ELEliseev/fb6-ebb/doc/4.jpeg

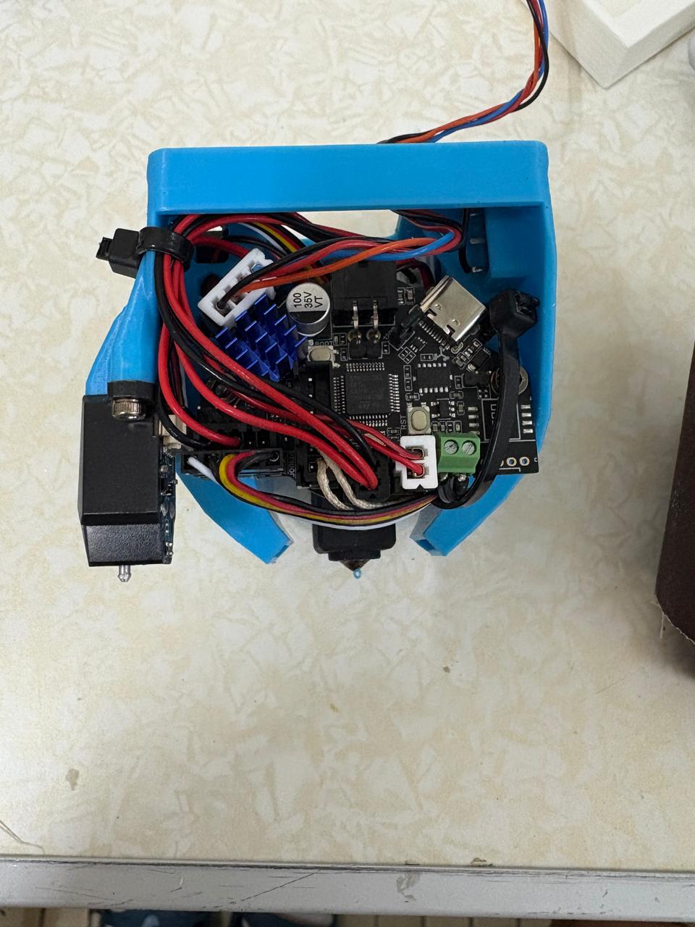
doc/4.jpeg
