ELEliseev/fb6-ebb/doc/10.jpeg

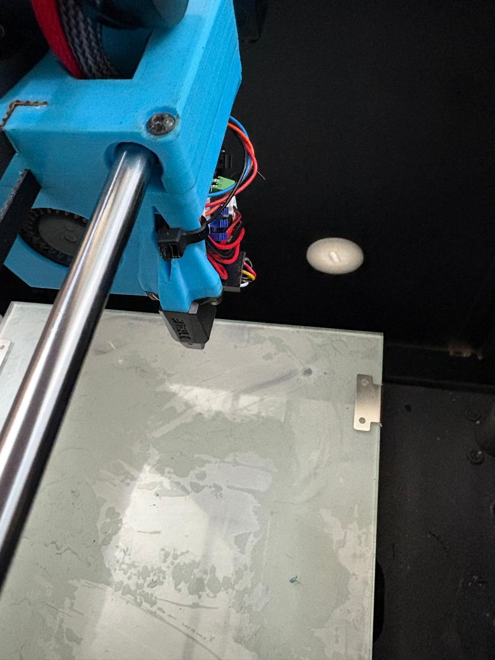
doc/10.jpeg
