ELEliseev/fb6-ebb/doc/Голова для 3д принтера flying bear ghost 6 под плату  ebb 36 can от btt.docx

## Голова для 3д принтера flying bear ghost 6 под плату ebb 36 can от btt.

### Данная система работает на прошивке klipper (у автора хост klipper на orange pi 3 lts)

> Печать

* Пластик ABS

* Слой 0.2мм

* Поддержки органические принудительно как на фото (каретка поддержки от стола)

* Периметры ,крышка, дно 5шт

* Заполнение 25% соты

> Плюсы

1. Избавляемся от лишних проводов, в том числе провод концевика X, который принтер вынужден таскать при печати.

2. Получаем акселерометр который встроен в плату, соответственно имеем автоматическую настройку input shaper.

3. Имеем нагреватель 60 ватт от volcano более надежный и мощный, также длинные каленые сопла.

4. Датчик microprobe biqu v2 легкий и при этом дает хорошие результаты в построении карты стола.

5. Голова получилась значительно легче штатной ,что позволяет печатать на высоких скоростях.

6. Все вентиляторы подходят от родной головы.

7. Совместимость с проектом zohan

>Минусы

1. Цена компонентов

2. Провода обжимать придется самостоятельно

> Компоненты

1. Хотенд volcano https://www.ozon.ru/product/rashodnik-dlya-pechati-chernyy-black-1992553845/

2. Микровыключатель https://www.ozon.ru/product/2sht-mikrovyklyuchatel-omron-d2fc-f-7n-komplektuyushchie-dlya-klaviatur-i-myshey-2011207511/ (опционально)

3. Плата ebb 36 btt https://www.ozon.ru/product/bigtreetech-ebb36-can-instrumentalnaya-plata-podderzhki-canbus-pt100-s-max31865-dlya-u2c-ender3-1994421029/

4. Плата u2c btt https://www.ozon.ru/product/plata-adaptera-bigtreetech-u2c-v2-1-podderzhivaet-podklyuchenie-shiny-can-s-3-can-vyhodnoy-interfeys-2018211076/ (опционально в зависимости от наличия CAN интерфейса на хосте klipper)

5. Вплавляемые втулки нужно 10 шт , 8 - м3, 2 - м2.5 для крепления microprobe.

6. Microprobe biqu v2 https://www.ozon.ru/product/biqu-microprobe-v2-datchik-avtomaticheskogo-vyravnivaniya-sensornyy-3d-datchik-dlya-ender-1919546110/ (опционально)

7. Экструдер orbiter v2.5 https://www.ozon.ru/product/ekstruder-orbiter-v2-5-s-pryamym-privo-2394542590/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 (опционально)

8. Разветвитель провода кулеров обдува, в плате ebb 36, к сожалению, только 2 выхода для обдува, а в нашей схеме 2 кулера обдува и 1 кулер охлаждения хотенда, поэтому необходим разветвитель, они бывают в продаже, также можно изготовить самому

>Прошивка

Обновляем Klipper.

Инструкция по установке klipper Tombraider2006/klipperFB6: flyingbear ghost 6 klipper/ helpfull manuals for user. config, mods, hacks (https://github.com/Tombraider2006/klipperFB6?ysclid=mf85sic02a98146775)

Прошиваем платы свежей прошивкой есть инструкции на сайте KB3D Wiki.

U2C BTT U2C v2.1 CANBus Adapter Board | KB3D Wiki (https://wiki.kb-3d.com/en/home/btt/voron/u2c_v2)

EBB 36 BTT EBB36 CAN Toolhead Board | KB3D Wiki (https://wiki.kb-3d.com/en/home/btt/voron/BTT_EBB36)

Прошиваем в режиме с бутлоадером что бы потом не парится с обновлениями

Плата ebb 36 может работать по двум интерфейса CAN и USB (автор использует CAN) соответственно существует 2 прошивки под CAN и USB.

> Сборка

Предусмотрите крепление плат (у автора платы вынесены на заднюю стенку в корпусах на магнитах, может быть не лучшее решение).

Предусмотрите прокладку кабелей, неплохое решение убрать кабели в оплетку «змеиная кожа».

Провода лучше использовать aws мягкие . Для кабеля головы сечение 0,3 мм на CAN шину и 0,5 мм на питание, провода CAN шины скручиваем в витую пару (автор использовал шуруповерт).

Перед сборкой прошиваем платы.

На конечных платах CAN шины (в схеме автора их всего 2 ebb36 и u2c ) включаем jumper 120 Ом для терминирования шины.

Блок-схема включения компонентов есть в прикрепленных файлах.

Голова собирается просто, можно посмотреть на фото, аккуратно раскладывайте и подбирайте длину проводов, внутри есть небольшой фиксатор для проводов.

Вплавляются втулки 2шт на orbiter, 2шт на microprobe v2, 2шт для платы ebb 36, 4шт для соединения с кареткой.

Провода подсоединять согласно схемам от завода плат.

>Настройка

Конфиг klipper пример от автора:
