ELEliseev/fb6-ebb/doc/1.jpeg

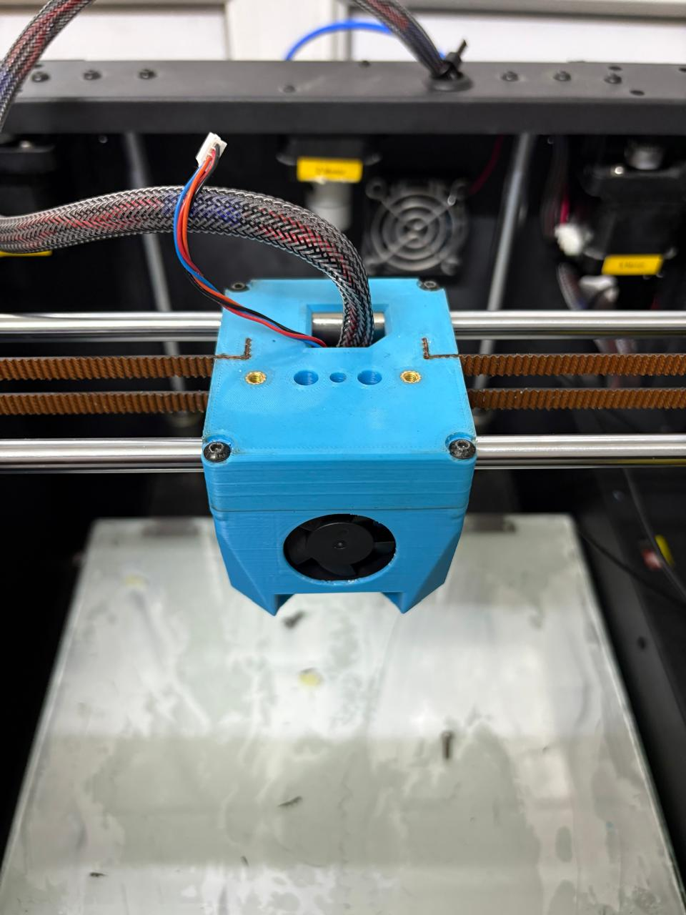
doc/1.jpeg
