ELEliseev/fb6-ebb/doc/2.jpeg

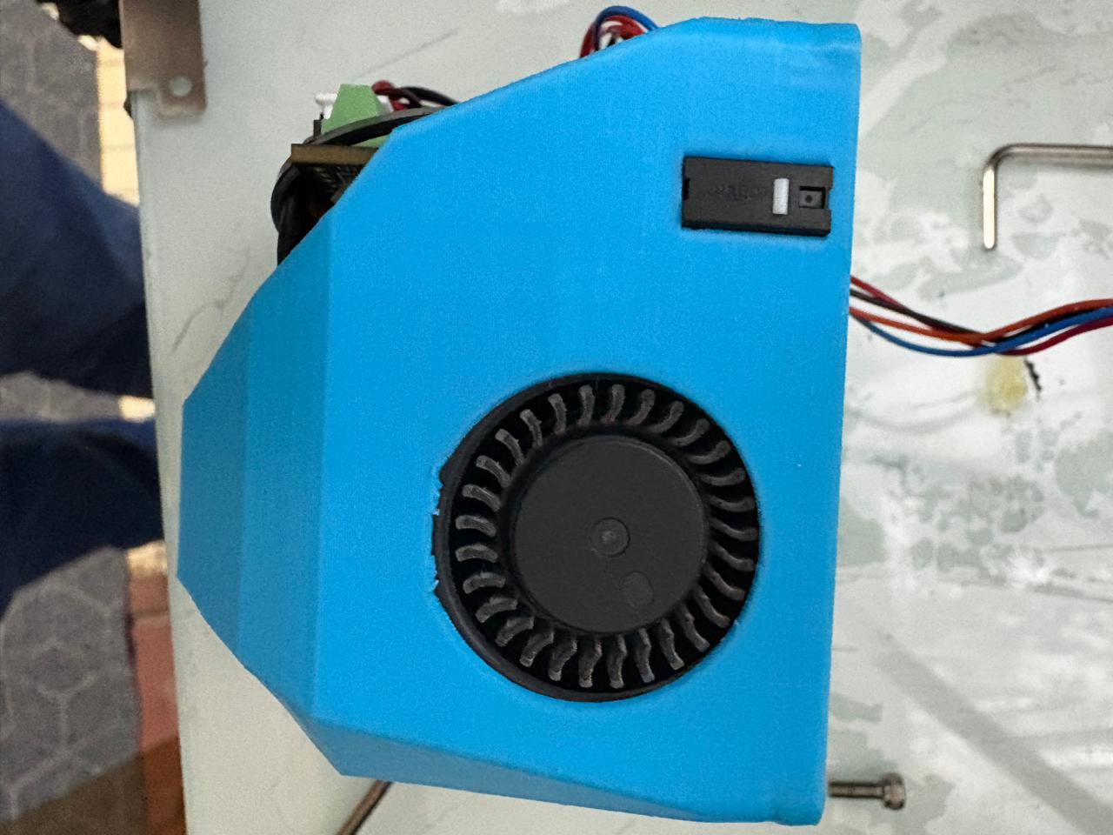
doc/2.jpeg
