ELEliseev/fb6-ebb/doc/3.jpeg

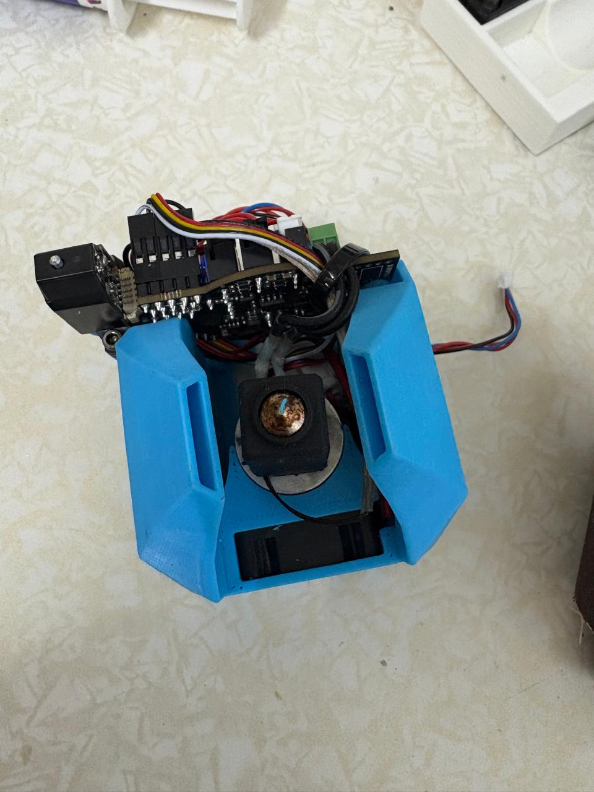
doc/3.jpeg
