ELEliseev/fb6-ebb/doc/5.jpeg

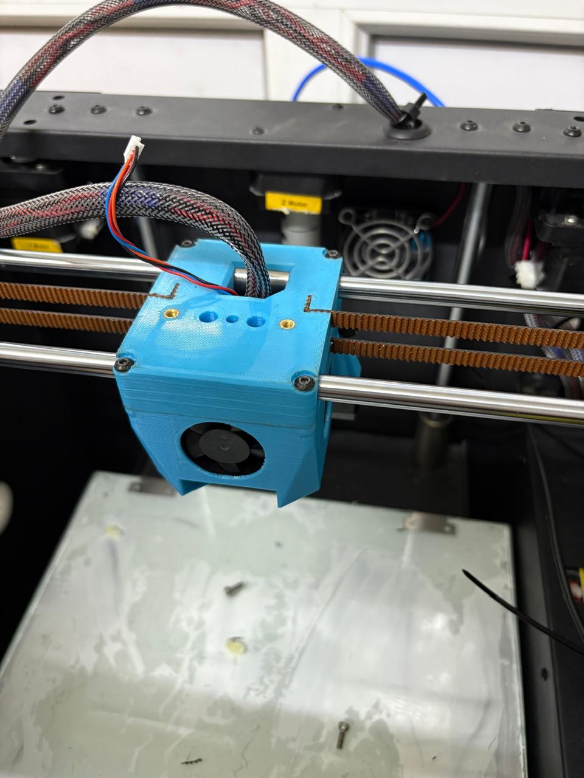
doc/5.jpeg
