ELEliseev/fb6-ebb/doc/6.jpeg

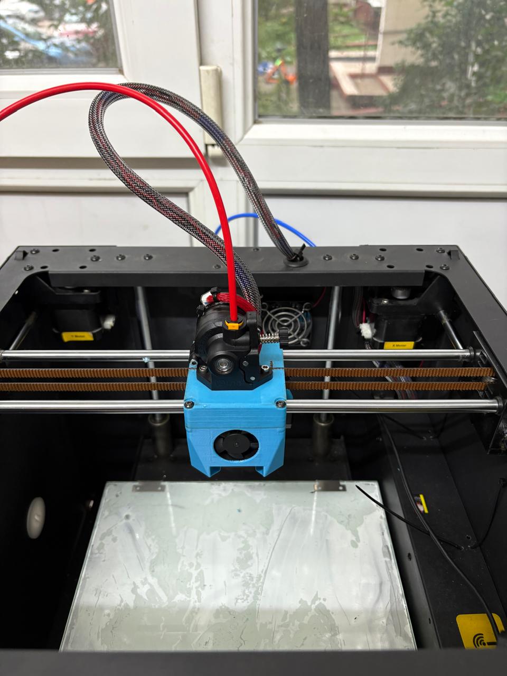
doc/6.jpeg
