ELEliseev/fb6-ebb/doc/7.jpeg

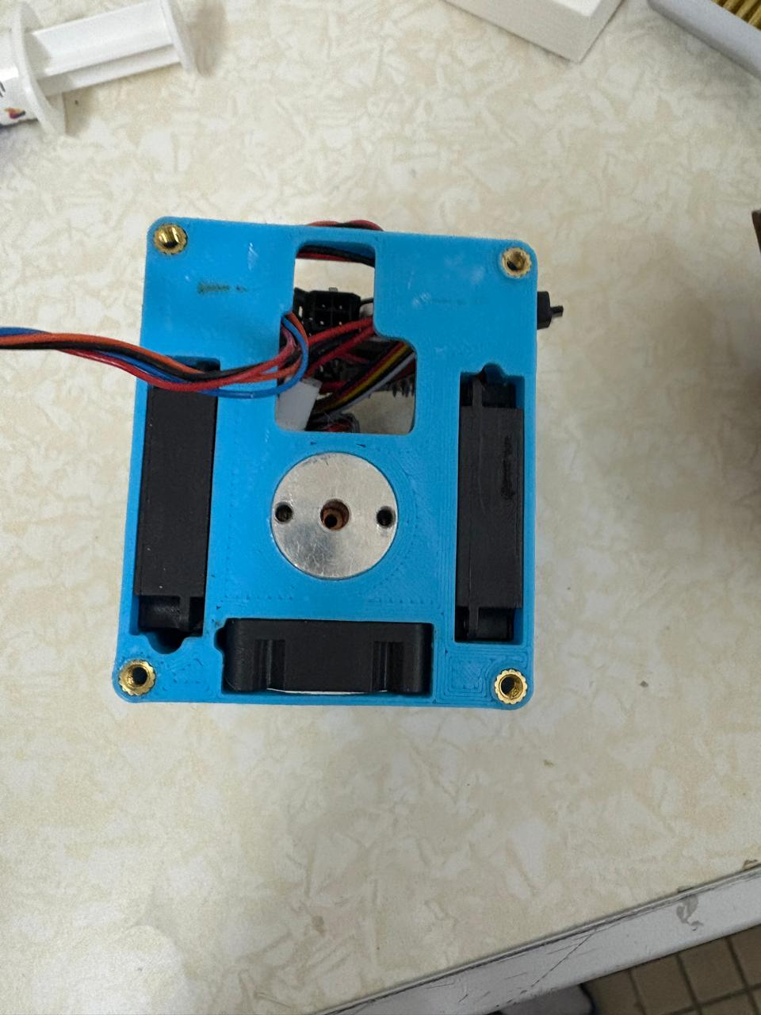
doc/7.jpeg
