ELEliseev/fb6-ebb/doc/8.jpeg

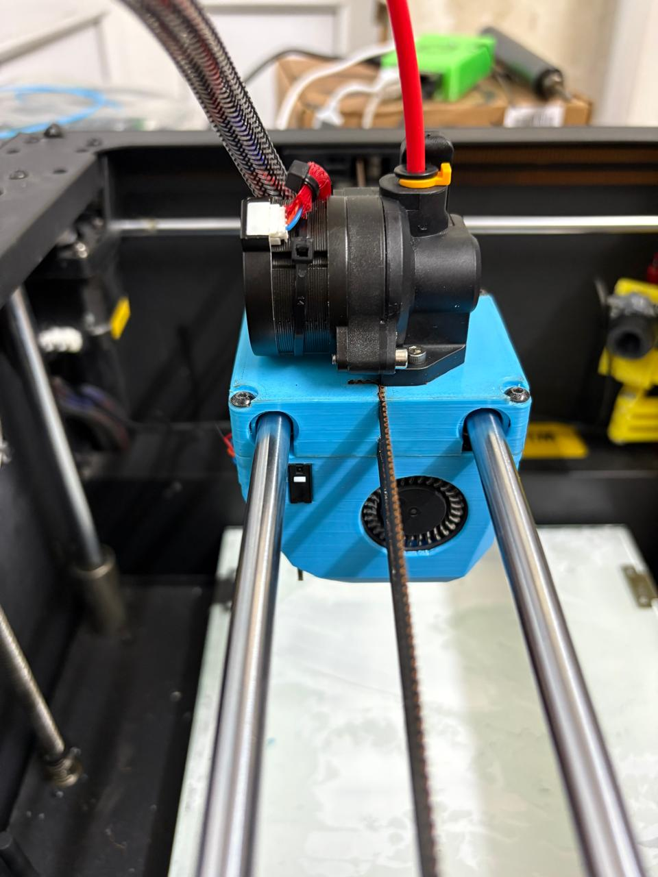
doc/8.jpeg
