ELEliseev/fb6-ebb/doc/9.jpeg

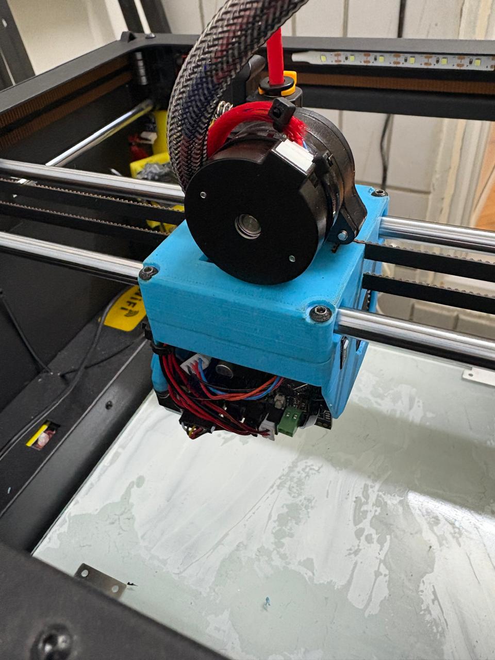
doc/9.jpeg
