ELEliseev/fb6-ebb/doc/11.jpeg

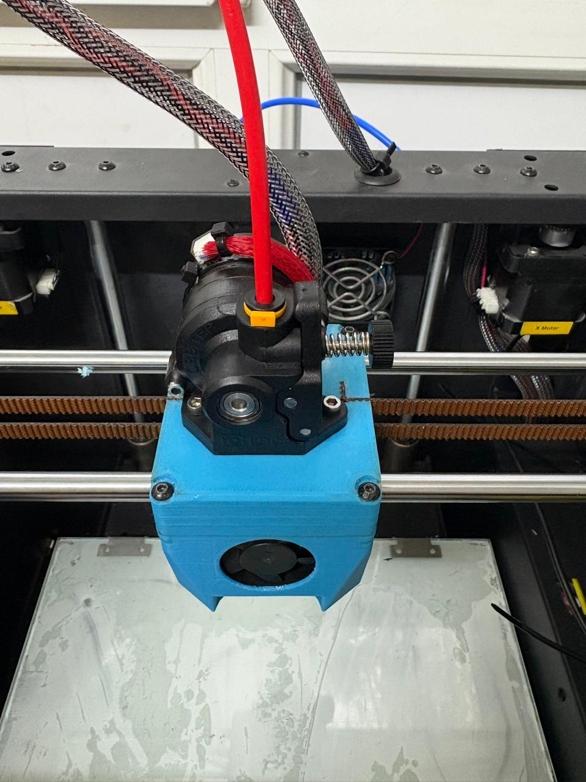
doc/11.jpeg
