ELEliseev/fb6-ebb/doc/12.jpeg

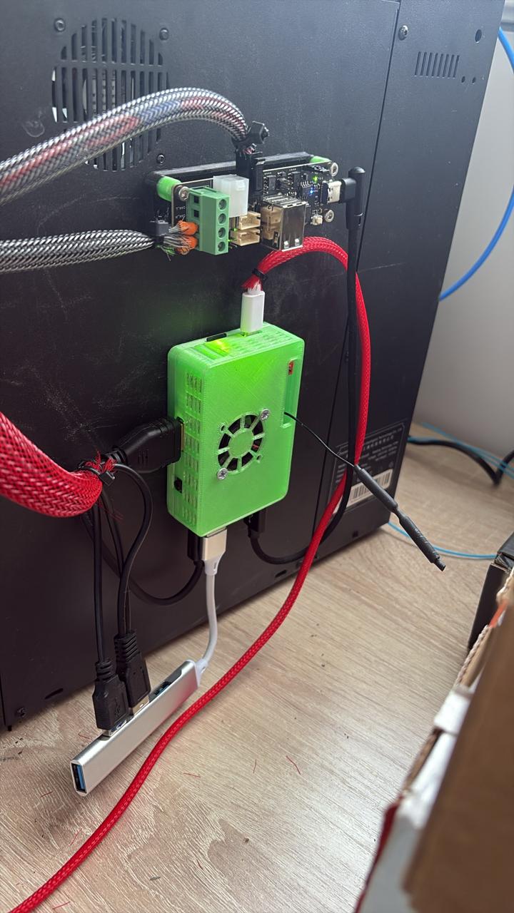
doc/12.jpeg
