ELEliseev/fb6-ebb/doc/13.jpeg

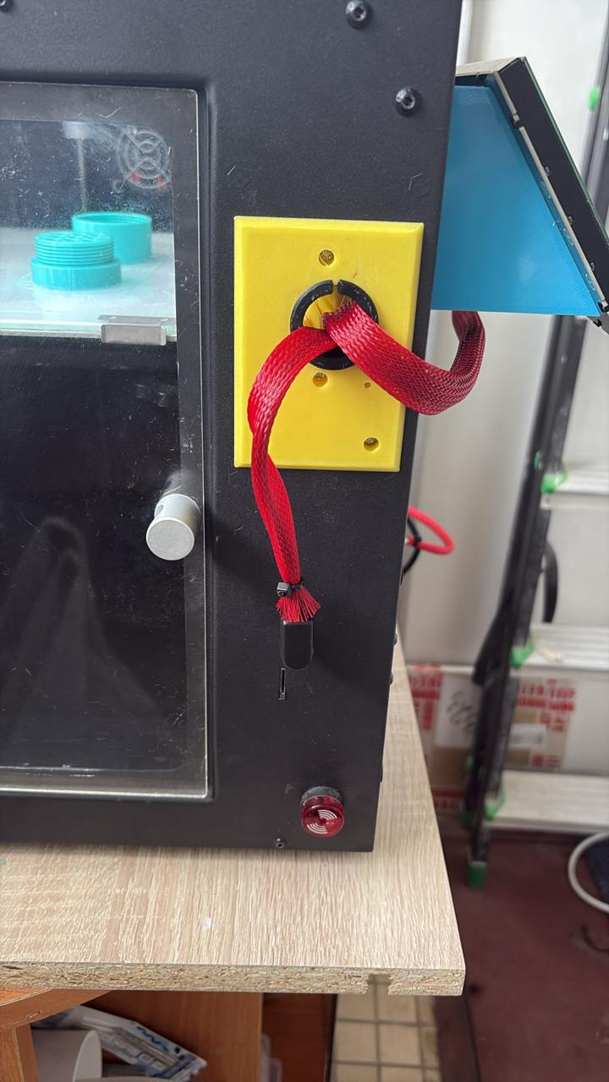
doc/13.jpeg
