ELEliseev/fb6-ebb/doc/14.jpeg

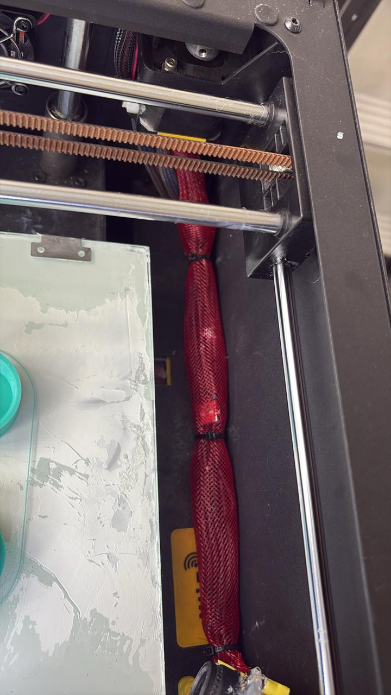
doc/14.jpeg
