ELEliseev/fb6-ebb/doc/15.jpeg

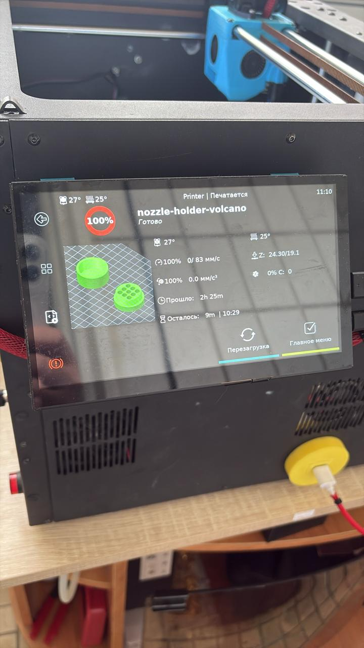
doc/15.jpeg
