ELEliseev/fb6-ebb/doc/btt36.png

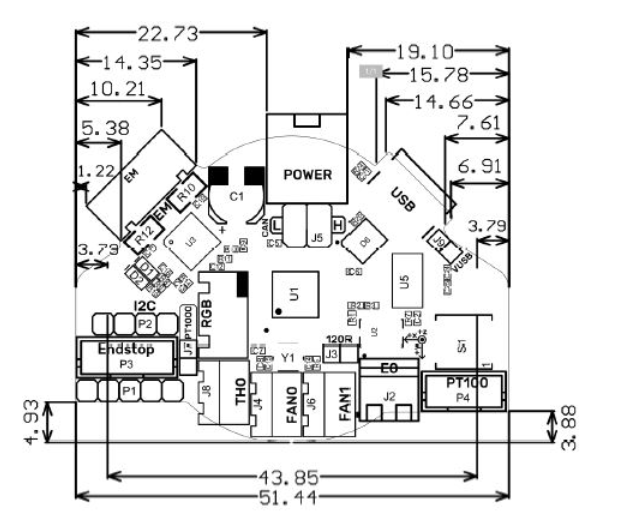
doc/btt36.png
