ELEliseev/fb6-ebb/doc/btt.png

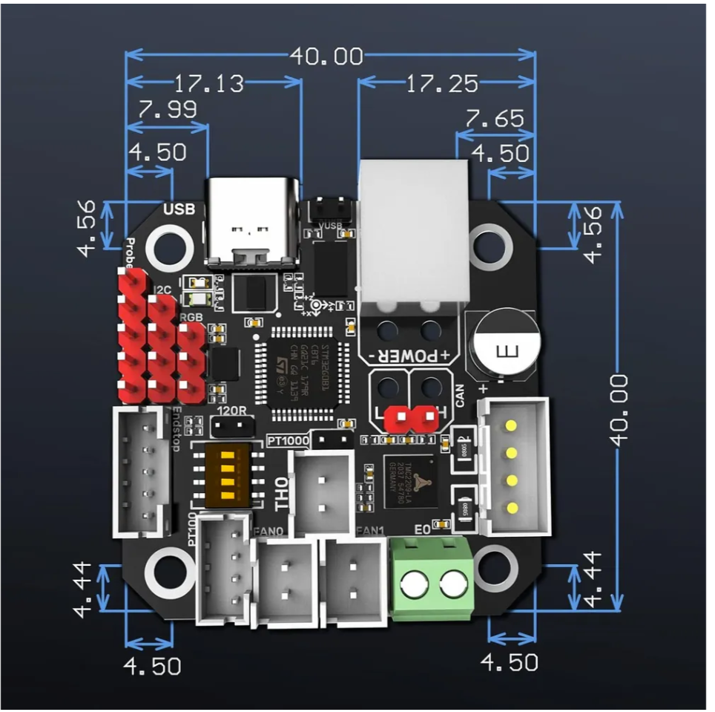
doc/btt.png
