ELEliseev/fb6-ebb/doc/схема.png

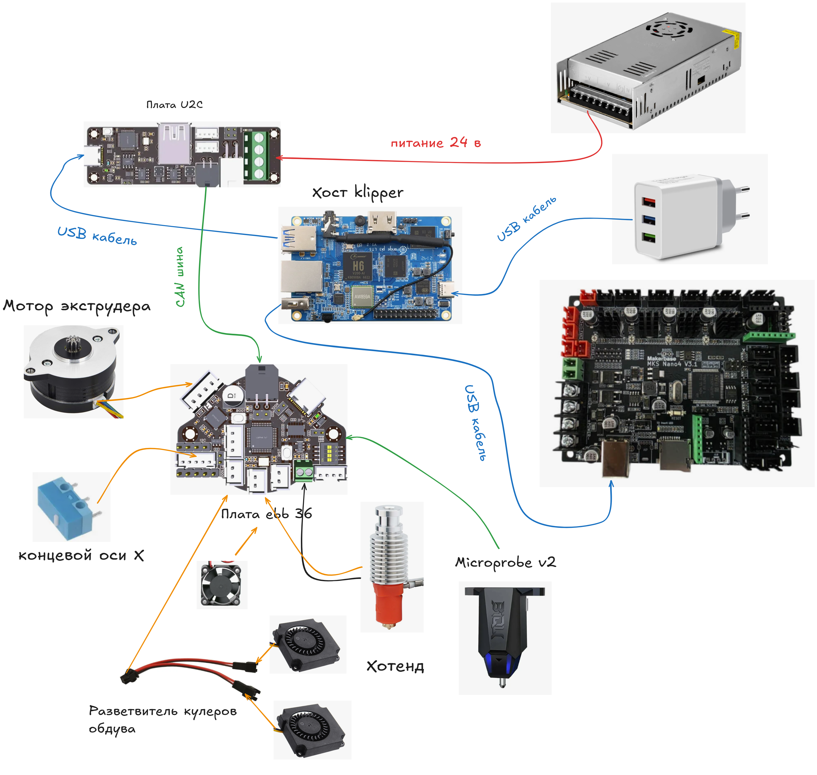
doc/схема.png
