ELEliseev/fb6-ebb/freecad/заглушка-катушки.FCStd

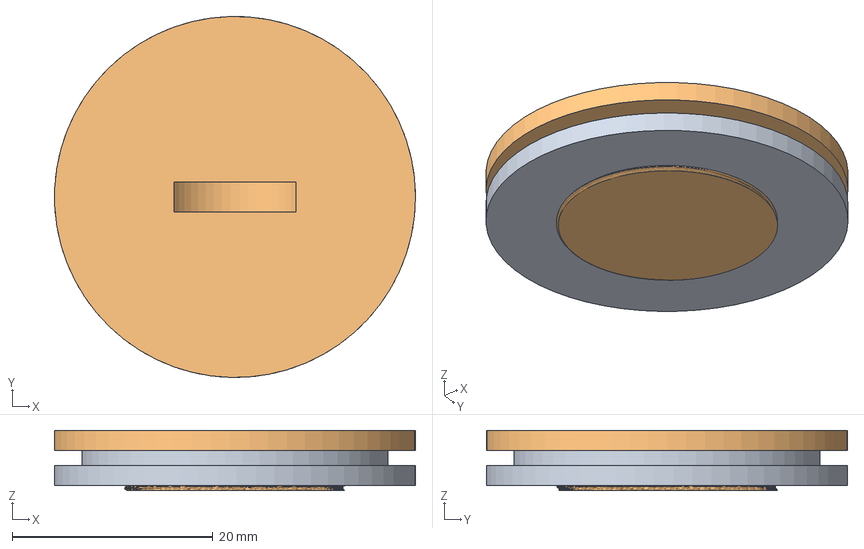
[picture p19: CAD file, 2025-09-06]
freecad/заглушка-катушки.FCStd
36.0 x 36.0 x 6.00 mm
гайка
