ELEliseev/fb6-ebb/freecad/проставка кабеля.FCStd

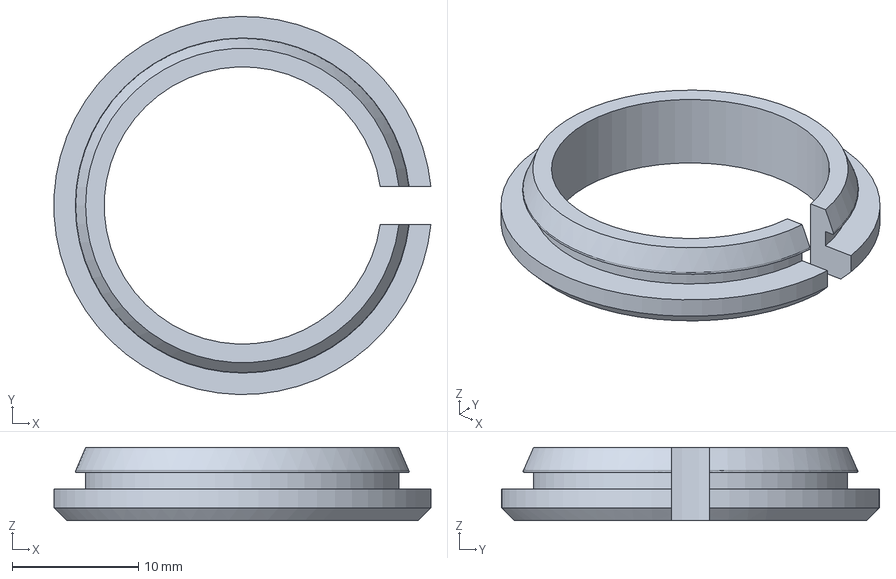
[picture p20: CAD file, 2025-08-23]
freecad/проставка кабеля.FCStd
29.9 x 30.0 x 5.80 mm
