ELEliseev/fb6-ebb/freecad/проставка кабеля длинная-Тело.stl

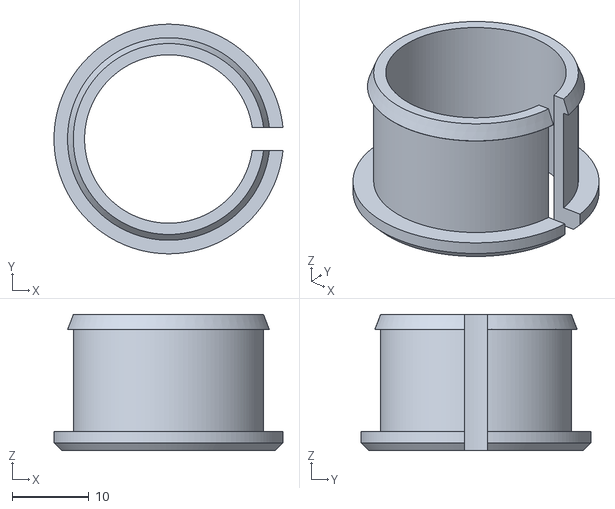
[picture p21: CAD file, 2025-08-23]
freecad/проставка кабеля длинная-Тело.stl
29.9 x 30.0 x 17.8
