ELEliseev/fb6-ebb/freecad/carret-orbiter.FCStd

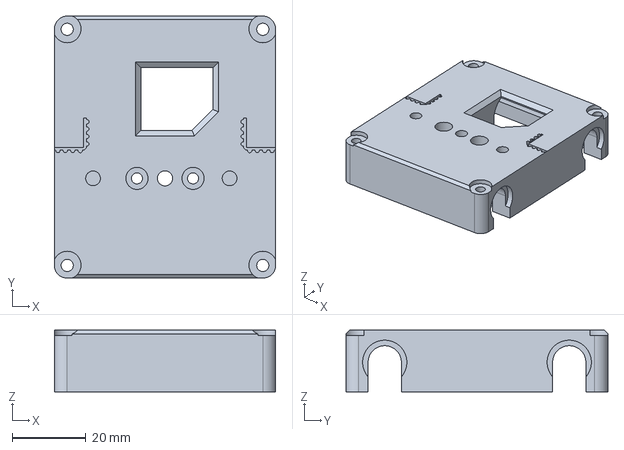
[picture p22: CAD file, 2025-08-23]
freecad/carret-orbiter.FCStd
60.0 x 71.0 x 16.7 mm
