ELEliseev/fb6-ebb/freecad/fbsbb-head.stl

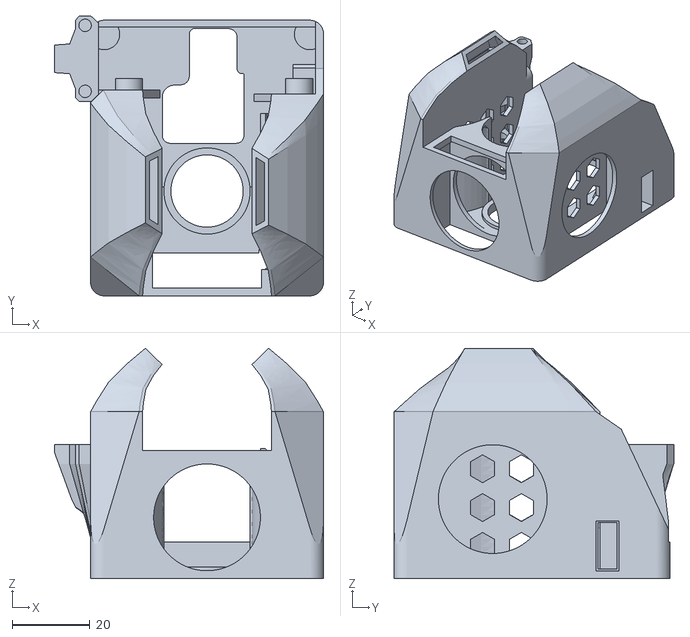
[picture p23: CAD file, 2025-08-16]
freecad/fbsbb-head.stl
69.3 x 72.0 x 59.3
