ELEliseev/fb6-ebb/(list of files, cad)

Other CAD files:
freecad/проставка кабеля-Тело.stl
freecad/проставка кабеля длинная.FCStd
freecad/carret-orbiter.stl
