ELEliseev/fb6-ebb/(commit log)

2025-08-16 add models
    [fbsbb-голова.stl, проставка кабеля-Тело.stl, проставка кабеля.FCStd]
2025-08-17 fix dir extruder
    [bigtreetech-ebb-canbus-v1.2.cfg, printer-20250816_215554.cfg, printer-20250816_220600.cfg, printer-20250816_221921.cfg, printer-20250816_222819.cfg]
2025-08-18 fix temp sensor remove
    [bigtreetech-ebb-canbus-v1.2.cfg, printer.cfg]
2025-08-23 fix z offset
    [bigtreetech-ebb-canbus-v1.2.cfg, printer.cfg]
2025-08-24 fix conf
    [bigtreetech-ebb-canbus-v1.2.cfg, carret-orbiter-Body.stl, printer.cfg]
2025-09-06 add quote
    [bigtreetech-ebb-canbus-v1.2.cfg, carret-orbiter.stl, fbsbb-head.stl, printer.cfg, заглушка-катушки.FCStd]
